NLevente97/Szakdolgozat/modells/MotorHolder1.pdf

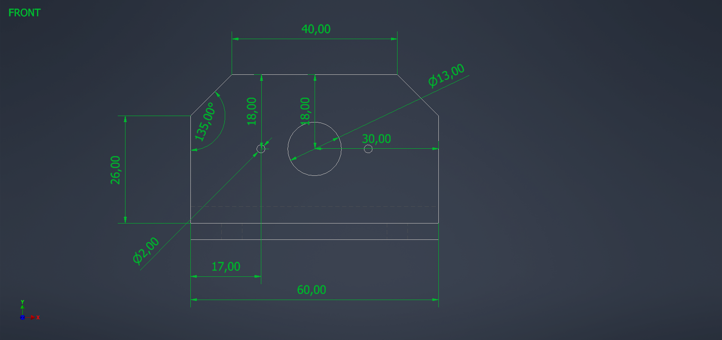
[picture p1: page 1]
