NLevente97/Szakdolgozat/modells/MotorHolder2.pdf

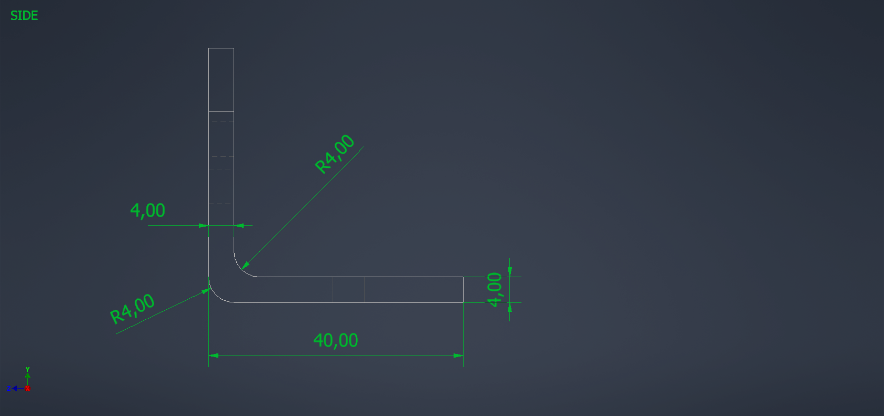
[picture p2: page 1]
