NLevente97/Szakdolgozat/modells/MotorHolder3.pdf

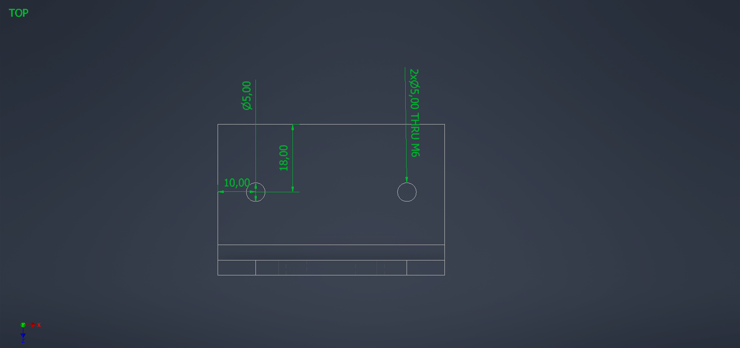
[picture p3: page 1]
