NLevente97/Szakdolgozat/modells/MotorHolderPic.pdf

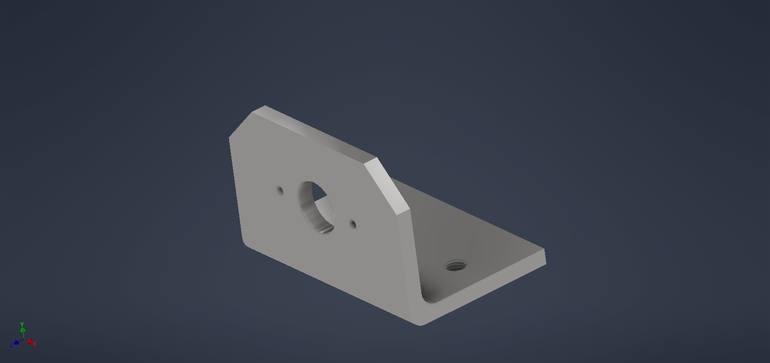
[picture p4: page 1]
