NLevente97/Szakdolgozat/modells/2022-12-19.png

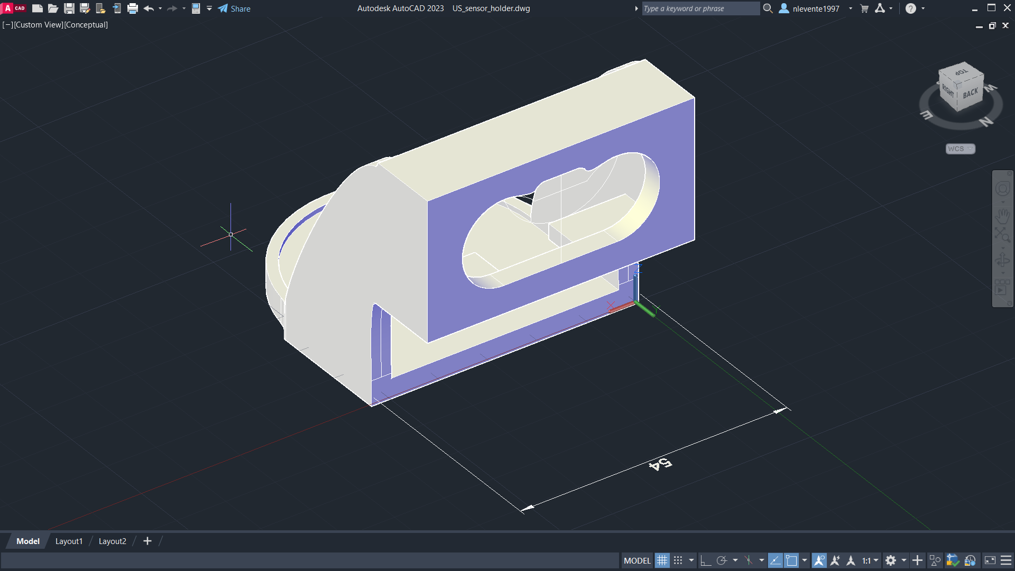
modells/2022-12-19.png
