NLevente97/Szakdolgozat/modells/US_sensor_holder_v2_meretek.jpg

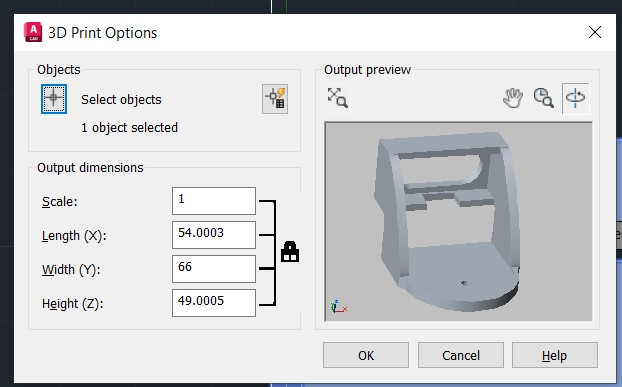
modells/US_sensor_holder_v2_meretek.jpg
