NLevente97/Szakdolgozat/oscilloscope/ALL0002/F0002TEK.JPG

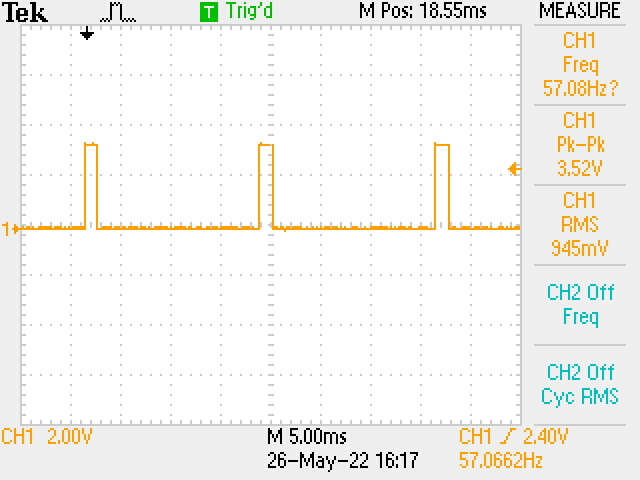
oscilloscope/ALL0002/F0002TEK.JPG
