NLevente97/Szakdolgozat/oscilloscope/ALL0013/F0013TEK.JPG

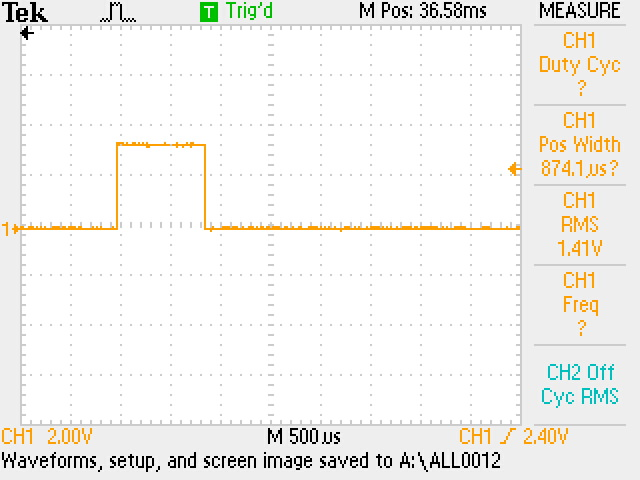
oscilloscope/ALL0013/F0013TEK.JPG
