NLevente97/Szakdolgozat/oscilloscope/ALL0014/F0014TEK.JPG

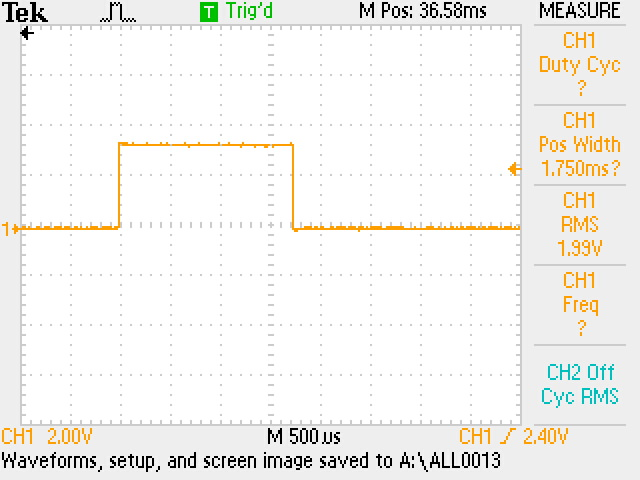
oscilloscope/ALL0014/F0014TEK.JPG
