NLevente97/Szakdolgozat/oscilloscope/ALL0015/F0015TEK.JPG

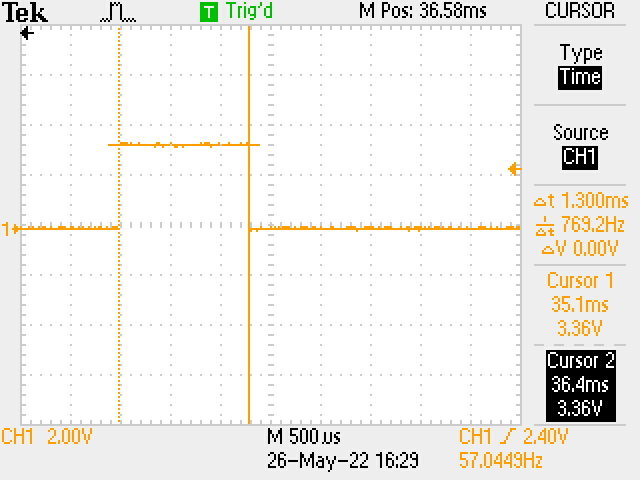
oscilloscope/ALL0015/F0015TEK.JPG
