NLevente97/Szakdolgozat/oscilloscope/ALL0016/F0016TEK.JPG

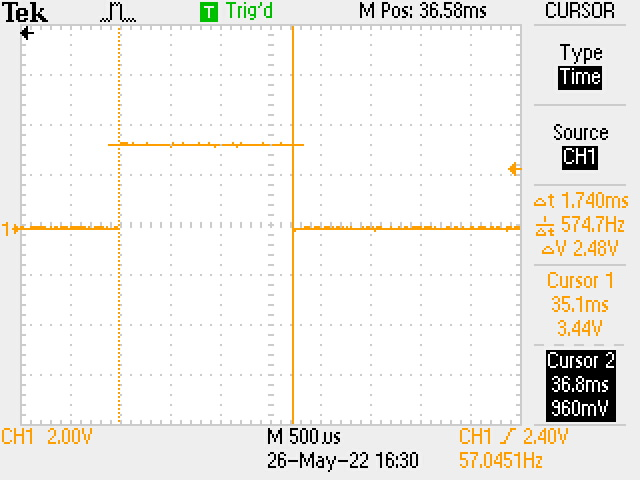
oscilloscope/ALL0016/F0016TEK.JPG
