NLevente97/Szakdolgozat/oscilloscope/ALL0018/F0018TEK.JPG

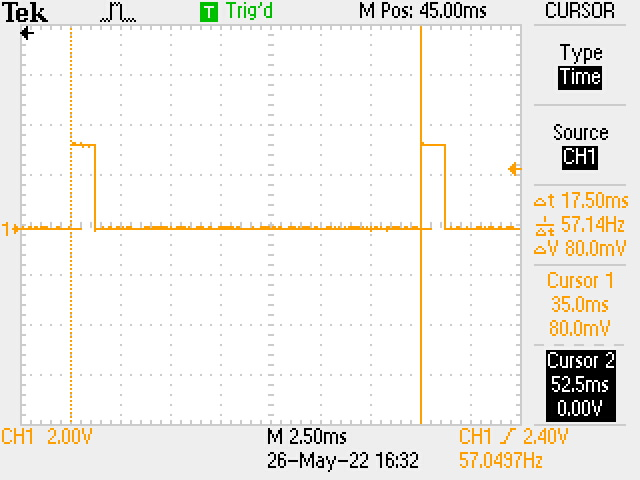
oscilloscope/ALL0018/F0018TEK.JPG
