NLevente97/Szakdolgozat/modells/US_sensor_holder_v2.stl

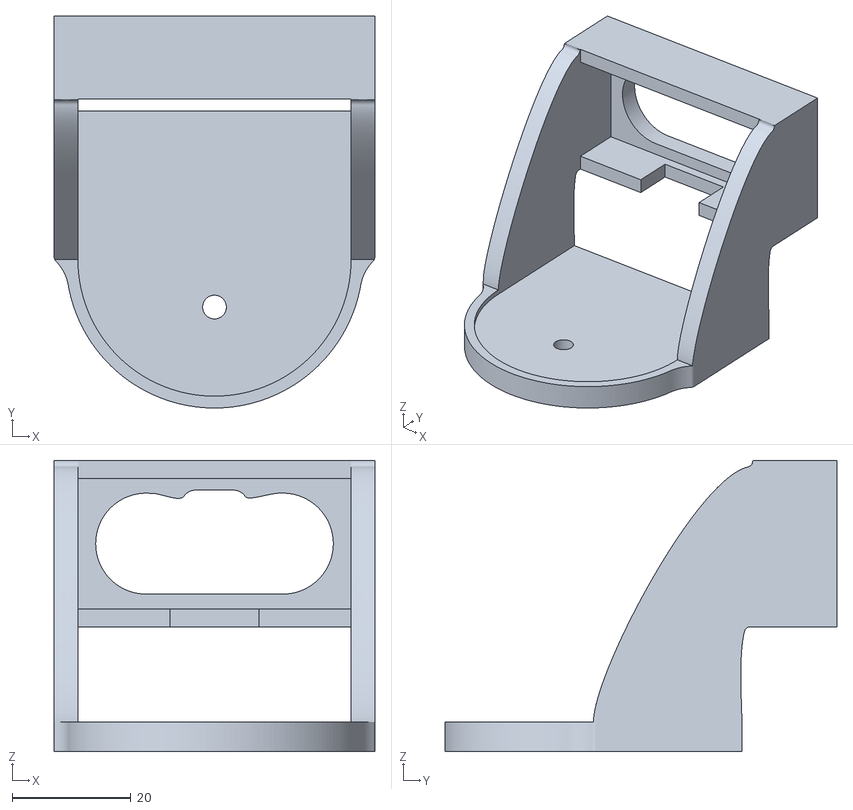
[picture p13: CAD file, 2023-01-06]
modells/US_sensor_holder_v2.stl
54.0 x 66.0 x 49.0
