NLevente97/Szakdolgozat/modells/Battery_holder.stl

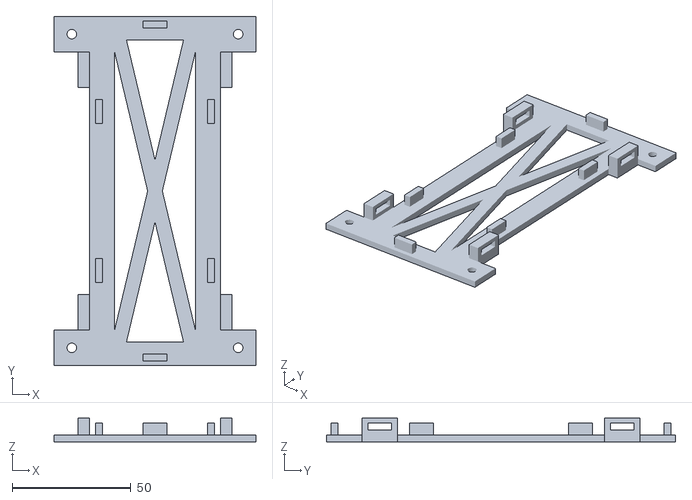
[picture p14: CAD file, 2023-01-06]
modells/Battery_holder.stl
85.0 x 147.0 x 10.00
