NLevente97/Szakdolgozat/modells/US_sensor_holder.stl

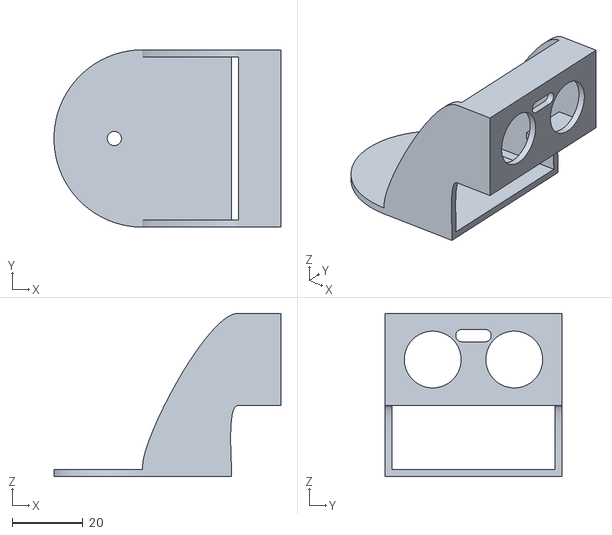
[picture p15: CAD file, 2023-01-06]
modells/US_sensor_holder.stl
64.0 x 50.0 x 46.0
