NLevente97/Szakdolgozat/(list of files, cad)

Other CAD files:
modells/Battery_holder.dwg
modells/DCMotor.ipt
modells/DCMotorAssembly.iam
modells/DCMotorPart.ipt
modells/Motor.ipt
modells/MotorHolder-01.ipt
modells/MotorHolder.iam
modells/MotorHolder.ipt
modells/MotorHolderAssembly.iam
modells/MotorHolderPart.ipt
modells/OldVersions/DCMotor.0002.ipt
modells/OldVersions/DCMotorAssembly.0002.iam
modells/OldVersions/Motor.0002.ipt
modells/OldVersions/MotorHolder.0010.ipt
modells/OldVersions/MotorHolderAssembly.0002.iam
modells/US_sensor_holder.dwg
