NLevente97/Szakdolgozat/PCB/SCH_Schematic1_2022-11-25.pdf

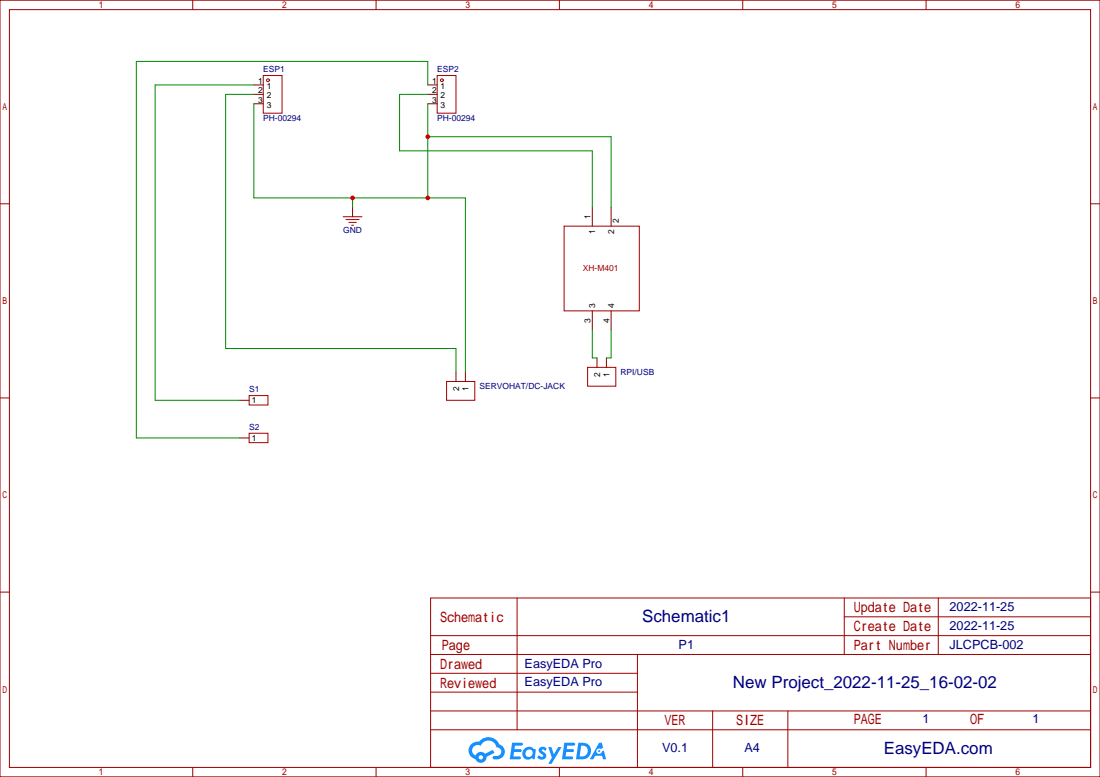
[picture p17: page 1]

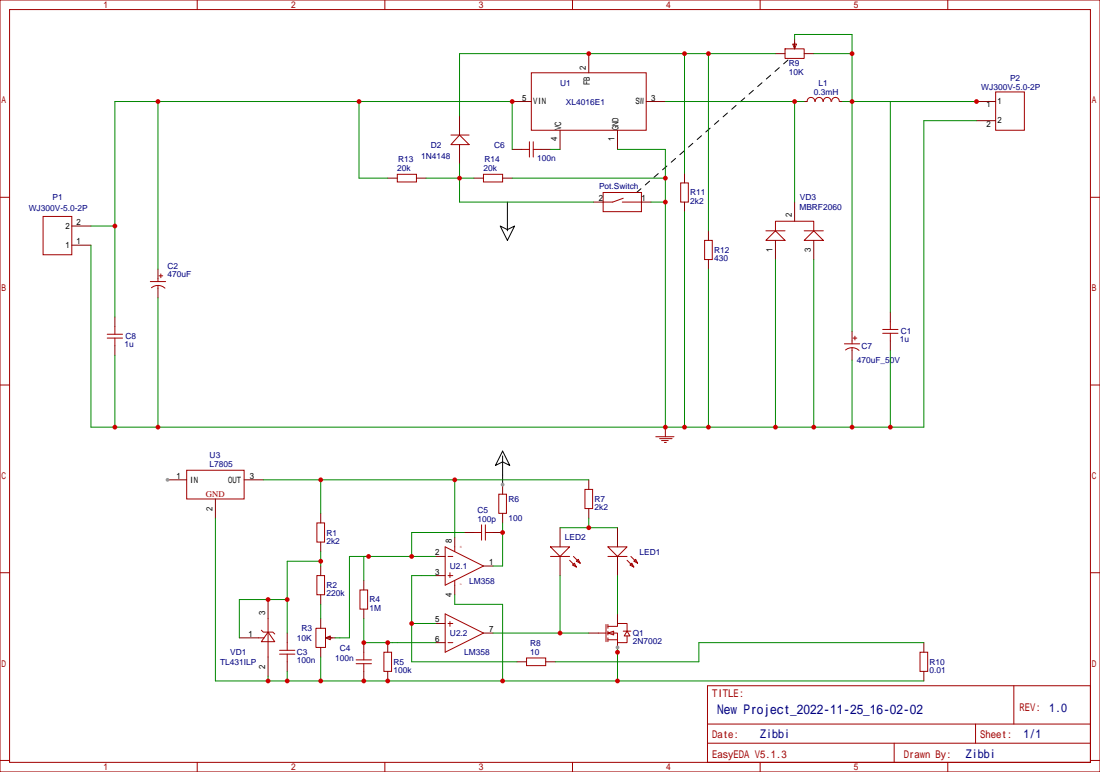
[picture p18: page 2]
