NLevente97/Szakdolgozat/(list of files, drawings)

Other design files:
PCB/New Project_2022-11-25_16-02-02.eprj
PCB/SCH_XH-M401_8A_2022-11-25.json
