NLevente97/Szakdolgozat/(commit log)

2022-05-20 basic control of the motors
2022-05-24 reworked motor control
2022-05-27 Added oscilloscope measurement results
    [F0002CH1.CSV, F0003CH1.CSV, F0004CH1.CSV, F0005CH1.CSV, F0006CH1.CSV, F0007CH1.CSV, F0008CH1.CSV, F0009CH1.CSV]
2022-05-27 Added a short report of the current state of the project
2022-05-27 fixed worng name in joystickcontroller.py and added log creating to launch.sh
    [joystickcontroller.py]
2023-01-06 added some 3D drawings
    [Battery_holder.dwg, Battery_holder.stl, DCMotor.0002.ipt, DCMotor.ipt, DCMotorAssembly.0002.iam, DCMotorAssembly.iam, DCMotorPart.ipt, Motor.0002.ipt]
2023-03-10 added basic ultrasonic sensor handling
2023-03-12 started to implement steering
2023-03-13 added sensor handling, and test data
